nevermore3d/Resin_Filtration/README.md

# Resin_Filtration
A repository for resin air filtration units
