nevermore3d/Resin_Filtration/Parapet_Filter_Tower/README.md

Parapet Filter Tower
====================

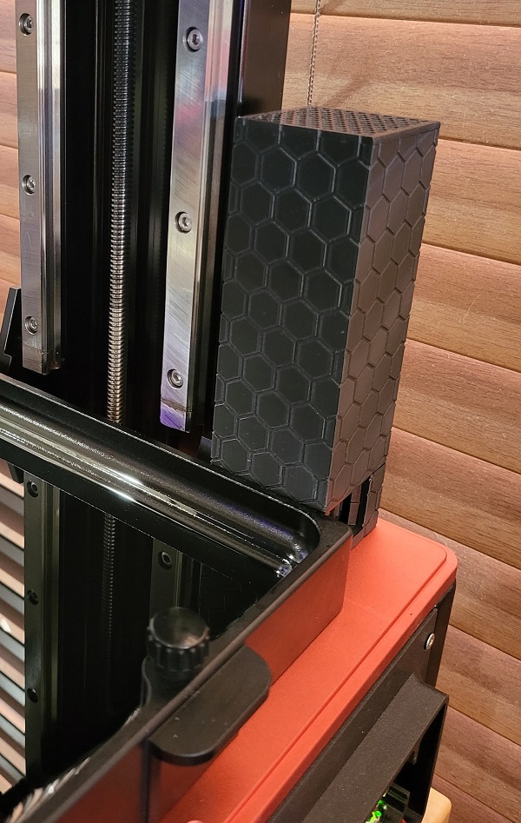
[picture p1: Parapet_Filter_Tower/Images/ParapetCropped.jpg]
parapet complete


Tired of the smell of resin permeating my office, and generally concerned about the health effects, I started to research filtration for resin printers. Elegoo sells an official air filter, however without refills, it's battery powered, and I have doubts about the actual filtration it can manage. Taking inspiration from the Nevermore project's recirculating filters, I decided to design my own system for placing behind the vat on my Elegoo Saturn.

This filter uses standard 4mm activated carbon pellets, about 90g per fill. Wiring information is tbd, I've hacked it into my Saturn, but a better system for driving the fans is in the works. Chamber heating is also planned, and may be integrated into a new Parapet base.

### BOM

* 4020 Blower fan, preferrably dual ball bearing
  * Voltage level is up to what you can provide, heres a selection of recommendations
  * [WINSINN 40mm Blower Fan 5V Dual Ball Bearing](https://www.amazon.com/WINSINN-40x20mm-Brushless-Cooling-Extruder/dp/B07L2YKR7Y)
  * [WINSINN 40mm Blower Fan 12V Dual Ball Bearing](https://www.amazon.com/WINSINN-40x20mm-Brushless-Cooling-Extruder/dp/B07L2YT1S3)
  * [WINSINN 40mm Blower Fan 24V Dual Ball Bearing](https://www.amazon.com/WINSINN-40x20mm-Brushless-Cooling-Extruder/dp/B07L2YH79Y) 
* 3x M3 heatset inserts
* 3x M3x20 Black Oxide SHCS (Stainless will not work, as it's not as ferrous)
* 3x 6x3mm round magnets

## Printing

All files should be printed in the provided orientations, good bed adhesion is needed to get the mesh to print correctly, but otherwise this should be pretty easy. 

## Assembly

1. Install the heatset inserts in the holes in the base  
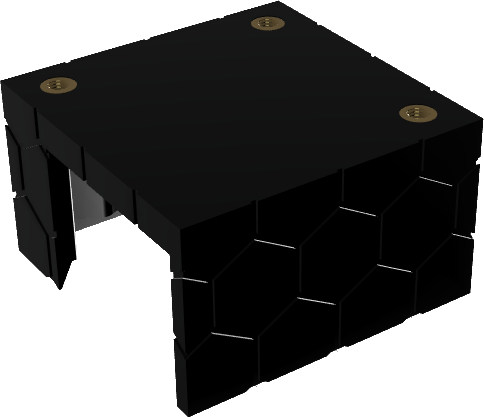
[picture p2: Parapet_Filter_Tower/Images/BaseHeatsets.png]
heatsets
   
1. Feed the 4020 wire through the side hole, and slide the fan into the base  
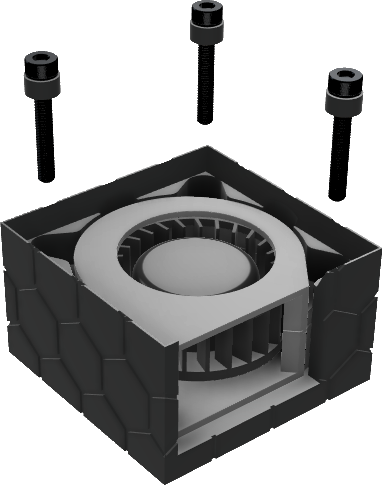
[picture p3: Parapet_Filter_Tower/Images/BaseScrewAssembly.png]
screws-assembly
   
2. Put the spacers on the m3x20 screws, and screw the fan into the base  
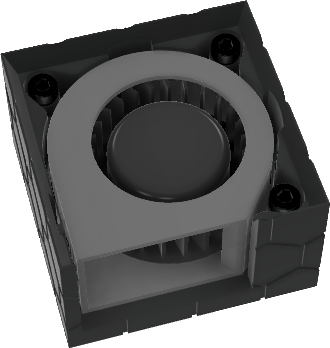
[picture p4: Parapet_Filter_Tower/Images/BaseScrewed.png]
base-complete
   
3. Install the magnets into the holes on the tower. Use glue if they don't snap fit  
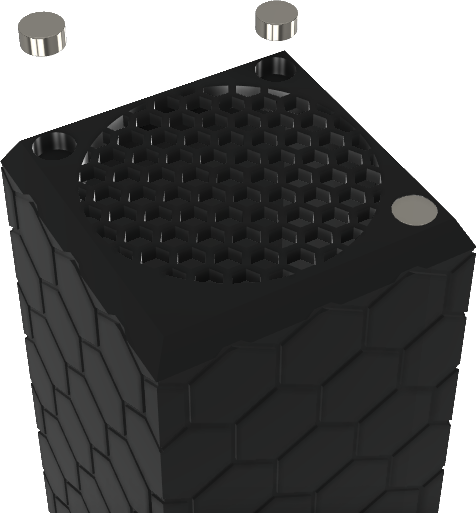
[picture p5: Parapet_Filter_Tower/Images/TowerMagnets.png]
tower with magnets
   
4. Fill the tower with activated carbon and snap the lid on  
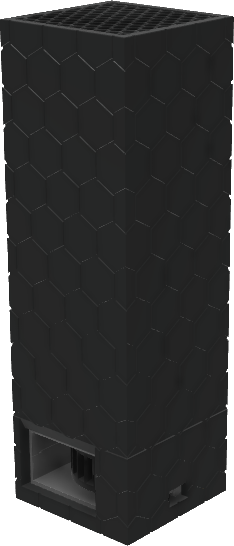
[picture p6: Parapet_Filter_Tower/Images/ParapetComplete.png]
parapet complete
   

The tower should now "snap" onto the base magnetically, and hold well enough to carry by the tower. You can use rubber cabinet feet, or VHB tape to attach the base to your printer. Run power to the fan, either by feeding the fan wiring through the Z axis holes in the base plate, a hole in the back of your printer, etc.

You should feel a gentle breeze when the fan is running, and slight suction at the top of the tower. If you don't, your fan is not powerful enough. I've only tested a 24v fan, but it pulls suction all the way down to 11v.
 
## Installation and Power

VHB foam tape can be used to attach the Parapet to your printer's base.

Powering the fan is up to the user, I have documented my current setup here.

DC fans can be speed controlled through voltage, so I chose to use a cheap [LM2596 DC-DC buck converter](https://www.amazon.com/dp/B07F3S5ZDX) and [JST-XHP Pigtail wires](https://www.amazon.com/dp/B07YWJKGR9) to make pigtail to get power from the ChituBoard's `MB_F` port. 

I soldered both a male and female connector to my LM2596 board, and a female to the DC-Out side. I plugged the stock cooling fan into the 24V side, then the Parapet's 4020 into the DC-Out. Tape over any bright LEDs on the LM2596 board just in case they have some UV emission.

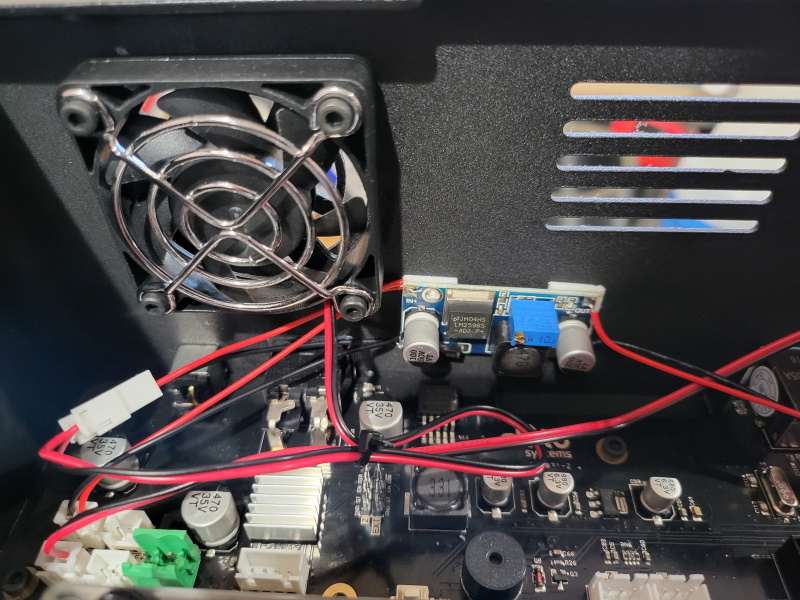
[picture p7: Parapet_Filter_Tower/Images/LM2596.jpg]
LM2596


I turned on the printer, and adjusted the voltage turning down the potentiometer until I could feel a gentle suction at the top of the Parapet (while filled with carbon pellets). I was able to fit the fan wires next to the Z endstop, 

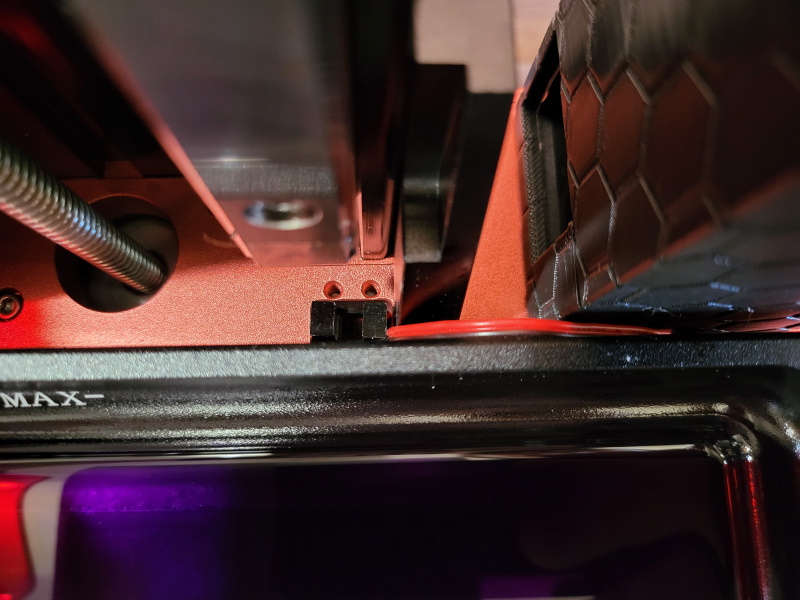
[picture p8: Parapet_Filter_Tower/Images/WirePastEndstop.jpg]
Fan wire through the endstop hole


## CAD

I've included a [STEP file](./CAD/Parapet.step) and [F3Z export](./CAD/Parapet.f3z) with this upload, and I've shared the full project for [Fusion 360](https://a360.co/3uRUeEG) as well. Contributions are welcome.
