nevermore3d/Resin_Filtration/Parapet_Filter_Tower/STLs/Base.stl

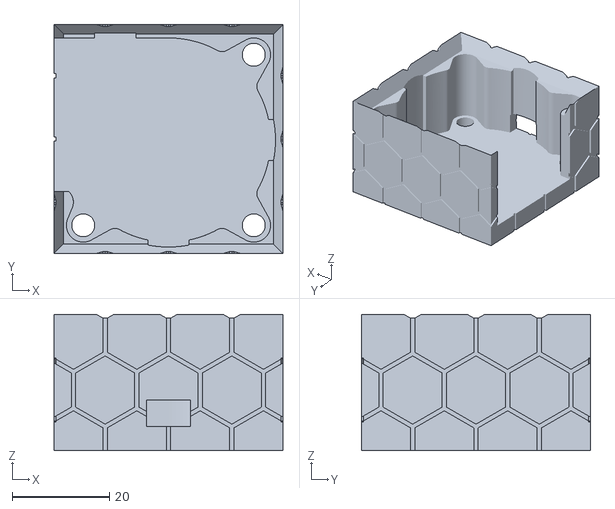
[picture p10: CAD file, 2021-10-08]
Parapet_Filter_Tower/STLs/Base.stl
47.0 x 47.0 x 28.0
