nevermore3d/Resin_Filtration/Parapet_Filter_Tower/STLs/FilterBox.stl

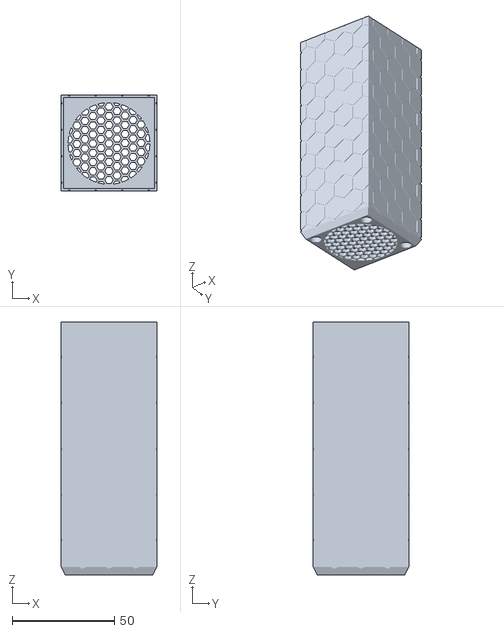
[picture p11: CAD file, 2021-10-08]
Parapet_Filter_Tower/STLs/FilterBox.stl
47.0 x 47.0 x 124.0
