nevermore3d/Resin_Filtration/Parapet_Filter_Tower/STLs/FilterLid.stl

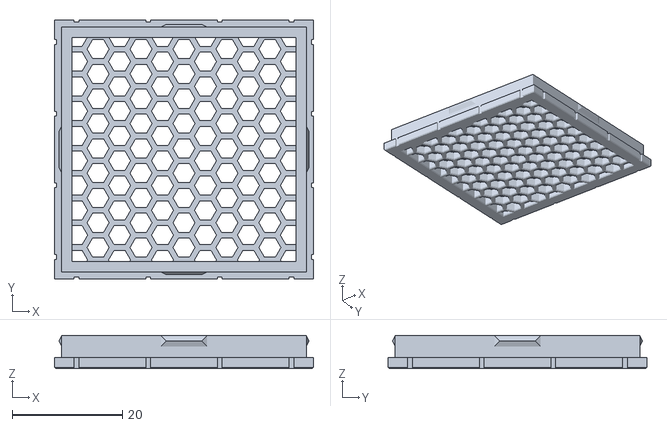
[picture p12: CAD file, 2021-10-08]
Parapet_Filter_Tower/STLs/FilterLid.stl
47.0 x 47.0 x 6.00
