nevermore3d/Resin_Filtration/Parapet_Filter_Tower/STLs/M3x3 Spacer x3.stl

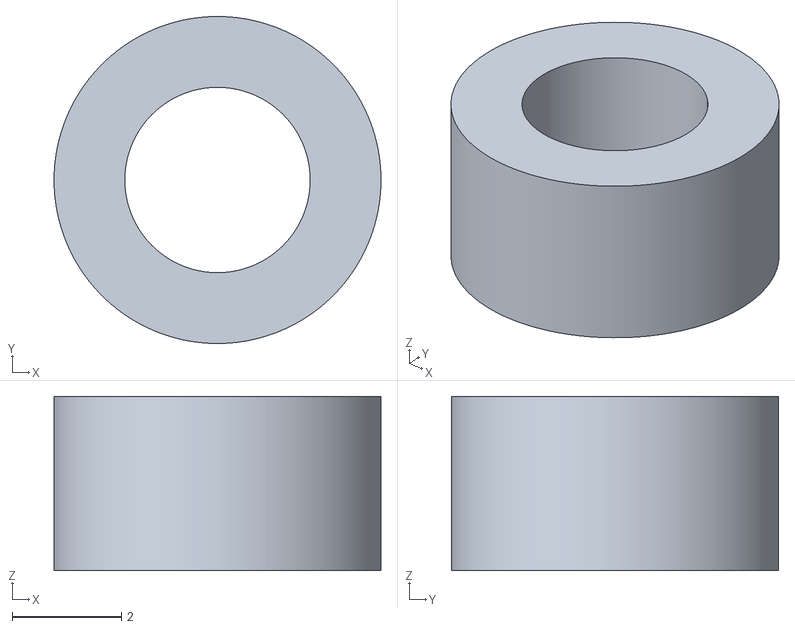
[picture p13: CAD file, 2021-10-08]
Parapet_Filter_Tower/STLs/M3x3 Spacer x3.stl
6.00 x 6.00 x 3.20
