nevermore3d/Resin_Filtration/(threads)

Thread 2 (2022-01-23):

Elegoo Mars 3

prnthp, 2022-01-23:
Not actually an issue. This is a wonderful design! Thank you!

I just wanted to add that the vacant `LED_F` port on the Chitu M20 board for the Mars 3 supplies 24 V while the printer is on.

I decided to route the wire externally through a gasket I printed so it is easier to move around and remove.

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

eduncan911, 2022-01-23:
That is fantastic!  Thank you!

Thread 3 (2022-09-05):

Anycubic Photon Mono (2k)

HeffordSJ, 2022-09-05:
Hello!

Much the same as the other "issue", this is more an FYI.

On the Anycubic Photon Mono (2k) there is a free 12v FAN port which works fine for this.

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

What's really nice is that while the stock printer doesn't ship with the fan installed it appears the port is all setup in firmware to turn on only while printing/the UV is active.

In terms of routing I plan to go through the gap by the rear optical sensor.

Many thanks again for starting this excellent project :)
