nevermore3d/Resin_Filtration/(commit log)

2021-10-08 Add parapet resin air filter (#1)
    [Base.stl, FilterBox.stl, FilterLid.stl, M3x3 Spacer x3.stl]
2021-10-08 Remove spaces from Parapet folder name
    [Base.stl, FilterBox.stl, FilterLid.stl, M3x3 Spacer x3.stl]
