nevermore3d/Resin_Filtration/Parapet_Filter_Tower/Images/Parapet.jpg

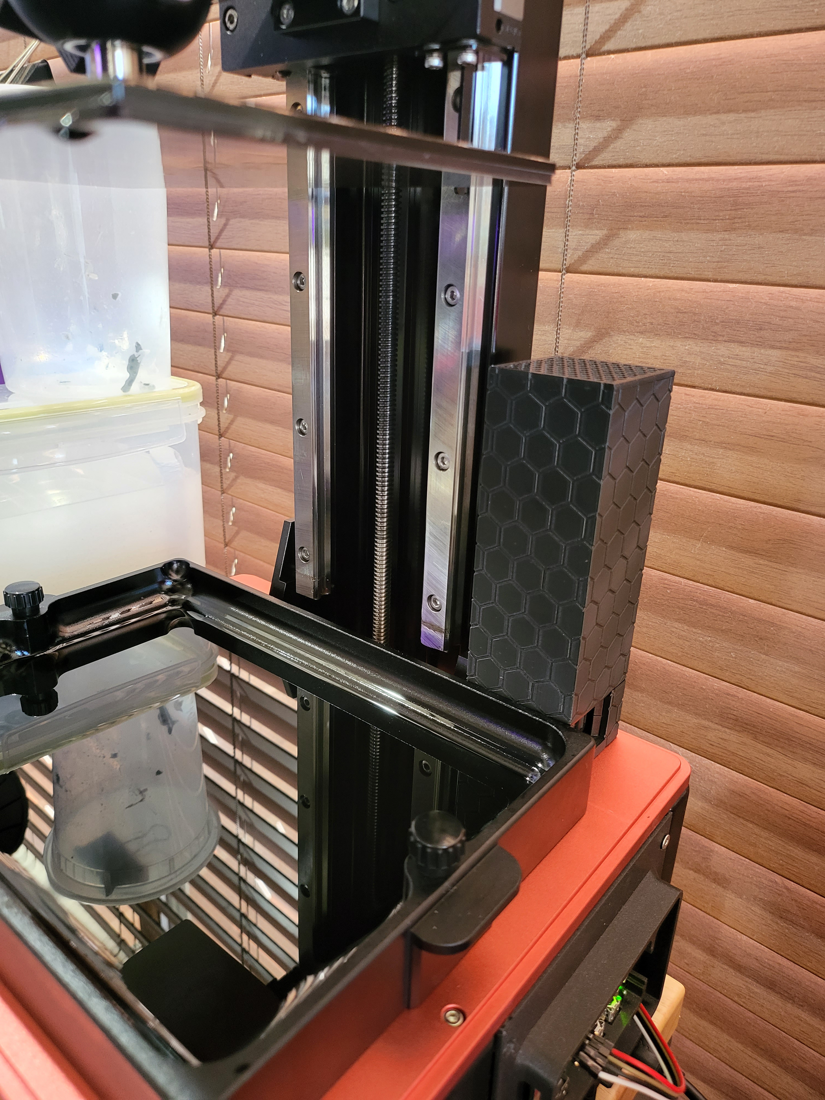
Parapet_Filter_Tower/Images/Parapet.jpg
